julessouren/kicad-library/README.md

# kicad-library

Attempt at creating a better library system via GitHub
