julessouren/kicad-library/Libraries - Archive/Archive - Models/3dfiles-for-pedal-various/Neutrik_Jacks-master/Neutrik_STLs/Neutrik_NMJ4HCD2.stl.stl

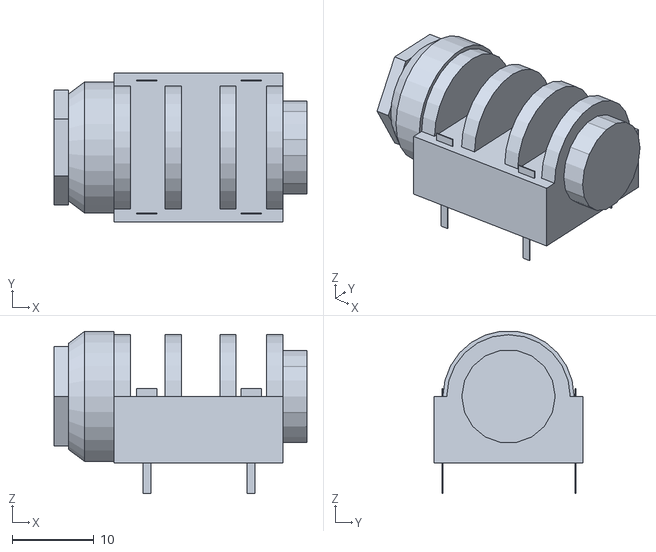
[picture p1: CAD file, 2019-09-03, an earlier design]
Libraries - Archive/Archive - Models/3dfiles-for-pedal-various/Neutrik_Jacks-master/Neutrik_STLs/Neutrik_NMJ4HCD2.stl.stl
30.9 x 18.2 x 19.8
