julessouren/kicad-library/Libraries - Archive/Archive - Models/Capacitors-THT-Film/User Library-Cap 10n - 630V Poly_2009.step

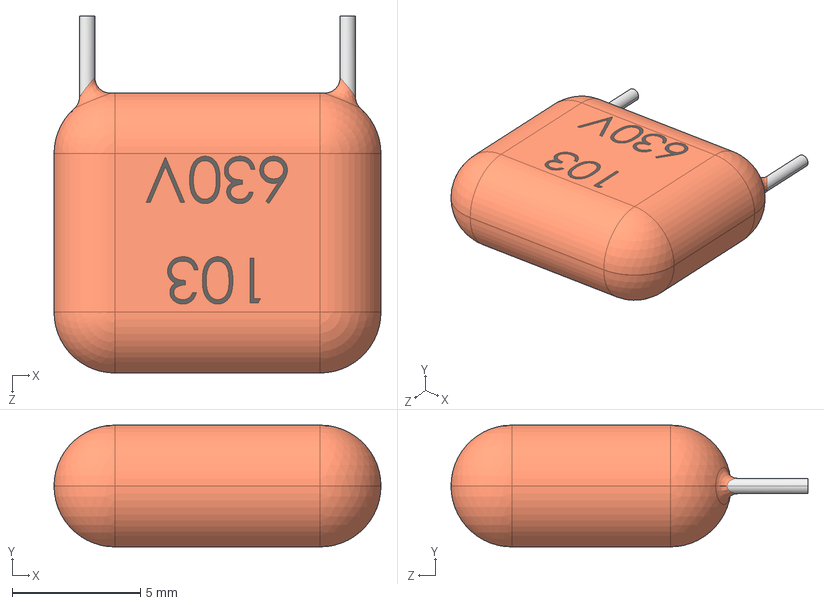
[picture p2: CAD file, 2019-09-03, an earlier design]
Libraries - Archive/Archive - Models/Capacitors-THT-Film/User Library-Cap 10n - 630V Poly_2009.step
12.8 x 4.75 x 13.9 mm
