julessouren/kicad-library/Libraries - Archive/Archive - Models/Capacitors-THT-Tantalum/User Library-CAP_TANT_0_1.step

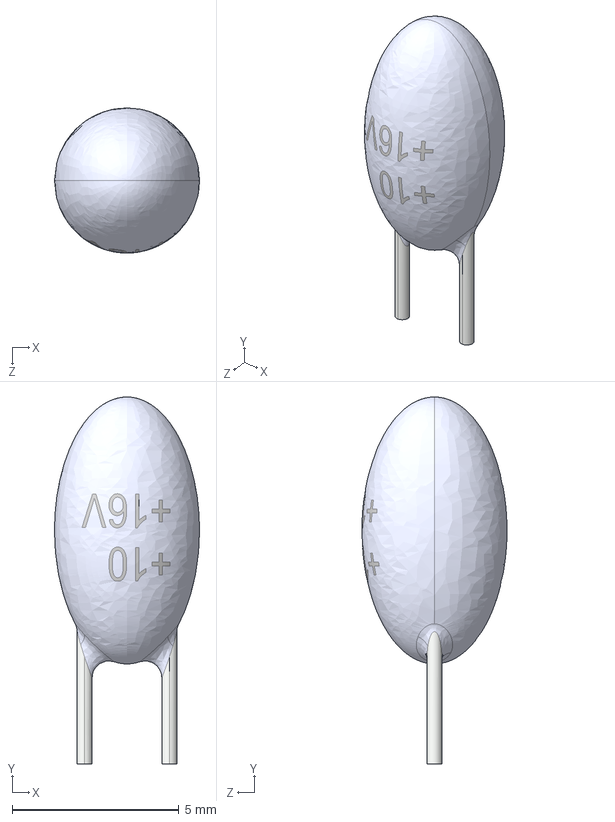
[picture p3: CAD file, 2019-09-03, an earlier design]
Libraries - Archive/Archive - Models/Capacitors-THT-Tantalum/User Library-CAP_TANT_0_1.step
4.35 x 11.0 x 4.35 mm
