julessouren/kicad-library/Libraries - Archive/Archive - Models/Enclosures/1590LB.stp

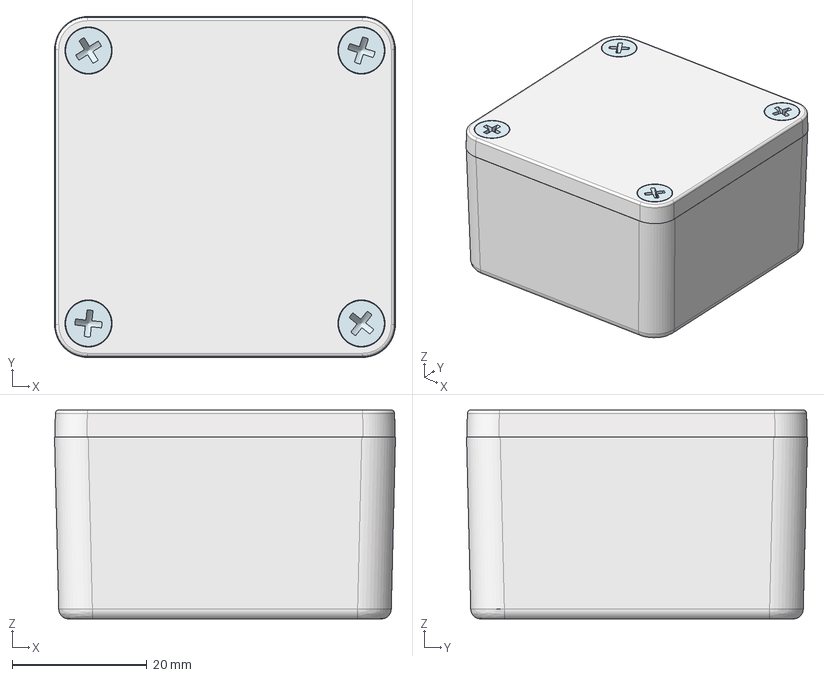
[picture p4: CAD file, 2019-09-03, an earlier design]
Libraries - Archive/Archive - Models/Enclosures/1590LB.stp
50.6 x 50.6 x 31.0 mm
1590LB Box
1590LB Lid
6-32 x 1/2" MACH. SCREW x 4
