julessouren/kicad-library/Libraries - Archive/Archive - Models/Jacks/Untitled Folder/Neutrik_Jacks-master/Neutrik_STLs/Neutrik_NRJ6HF.stl.stl

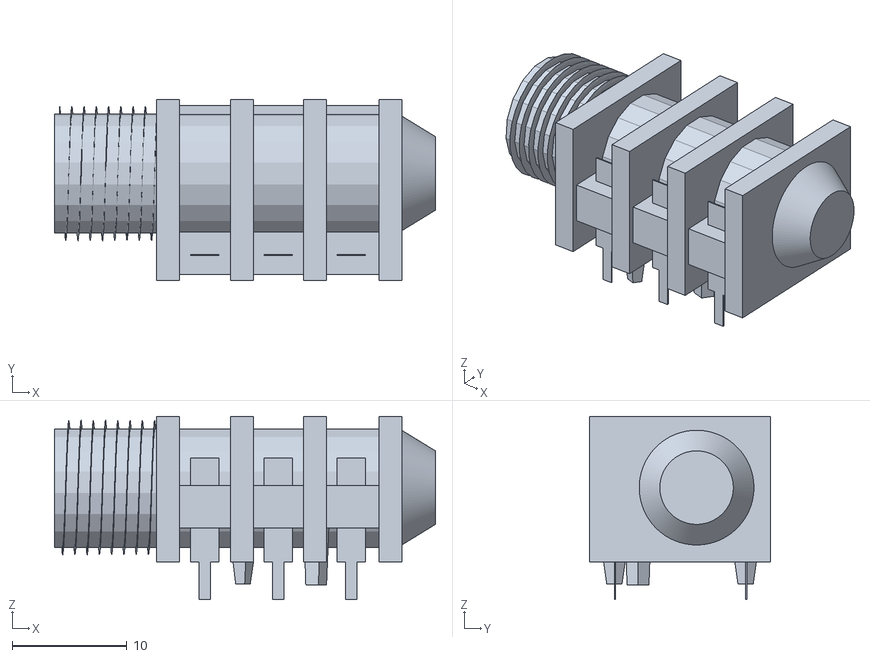
[picture p5: CAD file, 2019-09-03, an earlier design]
Libraries - Archive/Archive - Models/Jacks/Untitled Folder/Neutrik_Jacks-master/Neutrik_STLs/Neutrik_NRJ6HF.stl.stl
33.2 x 15.8 x 15.9
