julessouren/kicad-library/Libraries - Archive/Archive - Models/Potentiometers/Alpha9mm.step

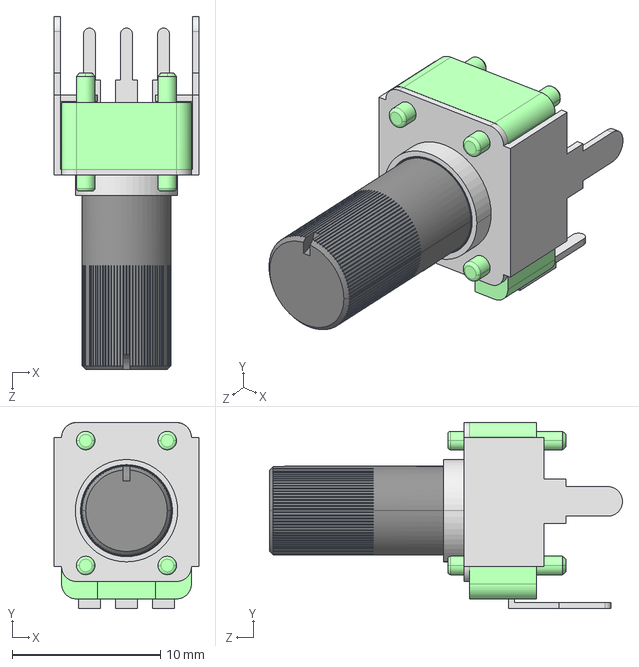
[picture p6: CAD file, 2019-09-03, an earlier design]
Libraries - Archive/Archive - Models/Potentiometers/Alpha9mm.step
9.75 x 12.6 x 23.8 mm
