julessouren/kicad-library/Libraries - Archive/Archive - Models/Trimpots/User Library-Bourns 3362P.step

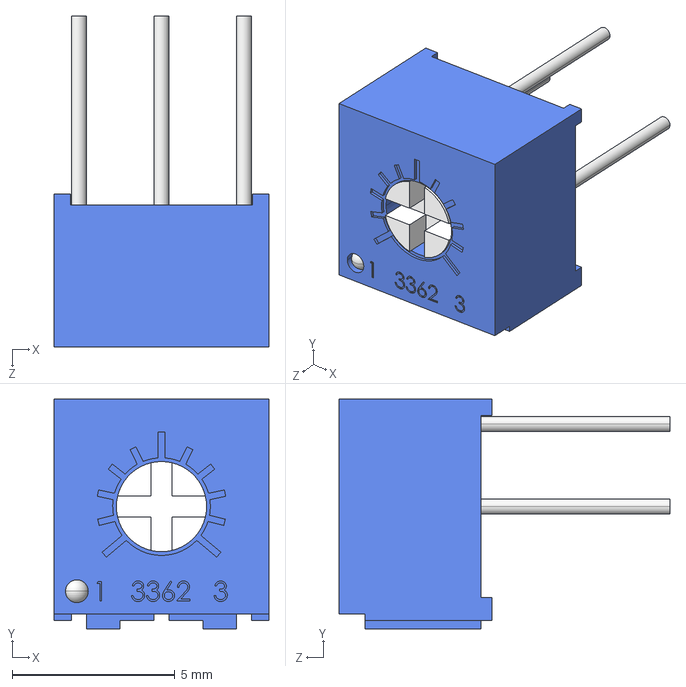
[picture p7: CAD file, 2019-09-03, an earlier design]
Libraries - Archive/Archive - Models/Trimpots/User Library-Bourns 3362P.step
6.60 x 7.05 x 10.2 mm
