julessouren/kicad-library/Libraries - Archive/Archive - Models/3dfiles-for-pedal-various/Neutrik_Jacks-master/Neutrik_STLs/Neutrik_NMJ4HFD2.stl.stl

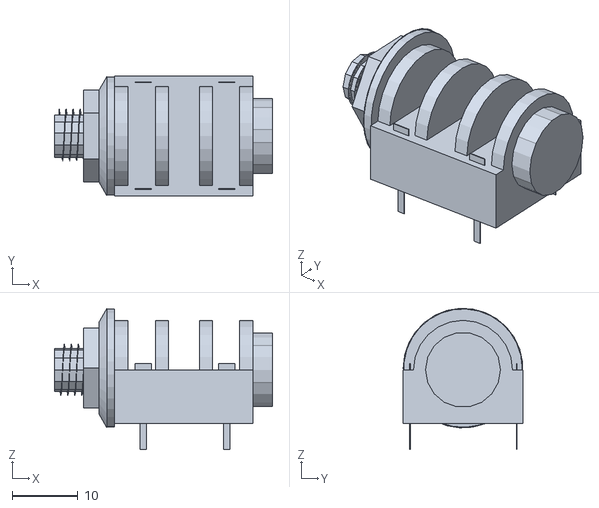
[picture p8: CAD file, 2019-09-03, an earlier design]
Libraries - Archive/Archive - Models/3dfiles-for-pedal-various/Neutrik_Jacks-master/Neutrik_STLs/Neutrik_NMJ4HFD2.stl.stl
33.1 x 18.2 x 21.5
