julessouren/kicad-library/Libraries - Archive/Archive - Models/Jacks/Untitled Folder/Neutrik_Jacks-master/Neutrik_STLs/Neutrik_NRJ4HF.stl.stl

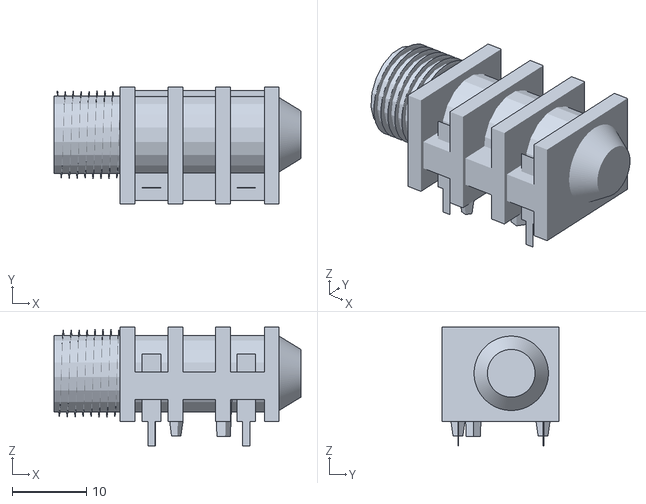
[picture p9: CAD file, 2019-09-03, an earlier design]
Libraries - Archive/Archive - Models/Jacks/Untitled Folder/Neutrik_Jacks-master/Neutrik_STLs/Neutrik_NRJ4HF.stl.stl
33.2 x 15.8 x 15.9
