julessouren/kicad-library/Libraries - Archive/Archive - Models/3dfiles-for-pedal-various/Neutrik_Jacks-master/Neutrik_STLs/Neutrik_NMJ6HCD3.stl.stl

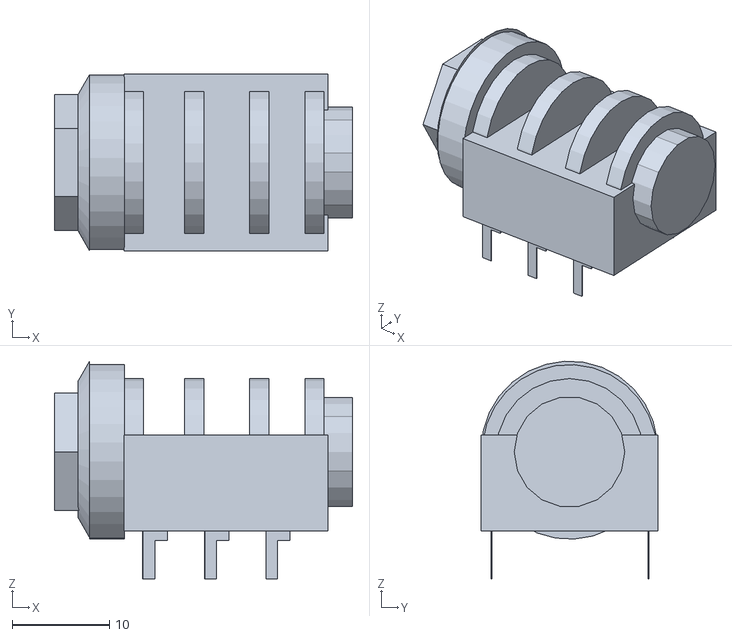
[picture p10: CAD file, 2019-09-03, an earlier design]
Libraries - Archive/Archive - Models/3dfiles-for-pedal-various/Neutrik_Jacks-master/Neutrik_STLs/Neutrik_NMJ6HCD3.stl.stl
30.7 x 18.2 x 22.4
