julessouren/kicad-library/(list of files, cad)

Other CAD files:
Libraries - Archive/Archive - Models/Potentiometers/Alpha9mmstepold.step
Libraries - Archive/Archive - Models/Jacks/Untitled Folder/Neutrik_Jacks-master/Neutrik_STLs/Neutrik_NMJ6HCD2.stl.stl
Libraries - Archive/Archive - Models/3dfiles-for-pedal-various/Neutrik_Jacks-master/Neutrik_STLs/Neutrik_NMJ6HCD2.stl.stl
Libraries - Archive/Archive - Models/3dfiles-for-pedal-various/Neutrik_Jacks-master/Neutrik_STLs/Neutrik_NMJ6HHD2.stl.stl
Libraries - Archive/Archive - Models/Jacks/Untitled Folder/Neutrik_Jacks-master/Neutrik_STLs/Neutrik_NRJ6HH.stl.stl
Libraries - Archive/Archive - Models/3dfiles-for-pedal-various/Neutrik_Jacks-master/Neutrik_openScad/Neutrik_NMJ4HCD2.scad
Libraries - Archive/Archive - Models/3dfiles-for-pedal-various/Neutrik_Jacks-master/Neutrik_openScad/Neutrik_NMJ4HFD2.scad
Libraries - Archive/Archive - Models/3dfiles-for-pedal-various/Neutrik_Jacks-master/Neutrik_openScad/Neutrik_NMJ4HFD3.scad
Libraries - Archive/Archive - Models/3dfiles-for-pedal-various/Neutrik_Jacks-master/Neutrik_openScad/Neutrik_NMJ4HHD2.scad
Libraries - Archive/Archive - Models/3dfiles-for-pedal-various/Neutrik_Jacks-master/Neutrik_STLs/Neutrik_NMJ4HFD3.stl.stl
Libraries - Archive/Archive - Models/3dfiles-for-pedal-various/Neutrik_Jacks-master/Neutrik_STLs/Neutrik_NMJ4HHD2.stl.stl
Libraries - Archive/Archive - Models/3dfiles-for-pedal-various/Neutrik_Jacks-master/Neutrik_STLs/Neutrik_NMJ6HFD2.stl.stl
Libraries - Archive/Archive - Models/3dfiles-for-pedal-various/Neutrik_Jacks-master/Neutrik_STLs/Neutrik_NMJ6HFD3.stl.stl
Libraries - Archive/Archive - Models/3dfiles-for-pedal-various/Neutrik_Jacks-master/Neutrik_STLs/Neutrik_NRJ3HF.stl.stl
Libraries - Archive/Archive - Models/3dfiles-for-pedal-various/Neutrik_Jacks-master/Neutrik_STLs/Neutrik_NRJ4HH.stl.stl
Libraries - Archive/Archive - Models/3dfiles-for-pedal-various/Neutrik_Jacks-master/Neutrik_STLs/Neutrik_NRJ6HH.stl.stl
Libraries - Archive/Archive - Models/3dfiles-for-pedal-various/Neutrik_Jacks-master/Neutrik_STLs/Neutrik_NRJ6HM-1.stl.stl
Libraries - Archive/Archive - Models/3dfiles-for-pedal-various/Neutrik_Jacks-master/Neutrik_openScad/Neutrik_NMJ6HCD2.scad
Libraries - Archive/Archive - Models/3dfiles-for-pedal-various/Neutrik_Jacks-master/Neutrik_openScad/Neutrik_NMJ6HCD3.scad
Libraries - Archive/Archive - Models/3dfiles-for-pedal-various/Neutrik_Jacks-master/Neutrik_openScad/Neutrik_NMJ6HFD2.scad
Libraries - Archive/Archive - Models/3dfiles-for-pedal-various/Neutrik_Jacks-master/Neutrik_openScad/Neutrik_NMJ6HFD3.scad
Libraries - Archive/Archive - Models/3dfiles-for-pedal-various/Neutrik_Jacks-master/Neutrik_openScad/Neutrik_NMJ6HHD2.scad
Libraries - Archive/Archive - Models/3dfiles-for-pedal-various/Neutrik_Jacks-master/Neutrik_openScad/Neutrik_NRJ3HF.scad
Libraries - Archive/Archive - Models/3dfiles-for-pedal-various/Neutrik_Jacks-master/Neutrik_openScad/Neutrik_NRJ4HF.scad
Libraries - Archive/Archive - Models/3dfiles-for-pedal-various/Neutrik_Jacks-master/Neutrik_openScad/Neutrik_NRJ4HH.scad
Libraries - Archive/Archive - Models/3dfiles-for-pedal-various/Neutrik_Jacks-master/Neutrik_openScad/Neutrik_NRJ6HF.scad
Libraries - Archive/Archive - Models/3dfiles-for-pedal-various/Neutrik_Jacks-master/Neutrik_openScad/Neutrik_NRJ6HH.scad
Libraries - Archive/Archive - Models/3dfiles-for-pedal-various/Neutrik_Jacks-master/Neutrik_openScad/Neutrik_NRJ6HM-1.scad
Libraries - Archive/Archive - Models/3dfiles-for-pedal-various/Neutrik_Jacks-master/Neutrik_openScad/Neutrik_NRJ6HM-1_PRE.scad
Libraries - Archive/Archive - Models/Capacitors-THT-Film/User Library-Cap 10n - 630V Poly_2009.igs
Libraries - Archive/Archive - Models/Enclosures/1590LB.igs
Libraries - Archive/Archive - Models/Jacks/Untitled Folder/Neutrik_Jacks-master/Neutrik_STLs/Neutrik_NMJ4HFD3.stl.stl
Libraries - Archive/Archive - Models/Jacks/Untitled Folder/Neutrik_Jacks-master/Neutrik_STLs/Neutrik_NMJ4HHD2.stl.stl
Libraries - Archive/Archive - Models/Jacks/Untitled Folder/Neutrik_Jacks-master/Neutrik_STLs/Neutrik_NMJ6HFD2.stl.stl
Libraries - Archive/Archive - Models/Jacks/Untitled Folder/Neutrik_Jacks-master/Neutrik_STLs/Neutrik_NMJ6HFD3.stl.stl
Libraries - Archive/Archive - Models/Jacks/Untitled Folder/Neutrik_Jacks-master/Neutrik_STLs/Neutrik_NMJ6HHD2.stl.stl
Libraries - Archive/Archive - Models/Jacks/Untitled Folder/Neutrik_Jacks-master/Neutrik_STLs/Neutrik_NRJ3HF.stl.stl
Libraries - Archive/Archive - Models/Jacks/Untitled Folder/Neutrik_Jacks-master/Neutrik_STLs/Neutrik_NRJ4HH.stl.stl
Libraries - Archive/Archive - Models/Jacks/Untitled Folder/Neutrik_Jacks-master/Neutrik_STLs/Neutrik_NRJ6HM-1.stl.stl
Libraries - Archive/Archive - Models/Jacks/Untitled Folder/Neutrik_Jacks-master/Neutrik_openScad/Neutrik_NMJ4HCD2.scad
Libraries - Archive/Archive - Models/Jacks/Untitled Folder/Neutrik_Jacks-master/Neutrik_openScad/Neutrik_NMJ4HFD2.scad
Libraries - Archive/Archive - Models/Jacks/Untitled Folder/Neutrik_Jacks-master/Neutrik_openScad/Neutrik_NMJ4HFD3.scad
Libraries - Archive/Archive - Models/Jacks/Untitled Folder/Neutrik_Jacks-master/Neutrik_openScad/Neutrik_NMJ4HHD2.scad
Libraries - Archive/Archive - Models/Jacks/Untitled Folder/Neutrik_Jacks-master/Neutrik_openScad/Neutrik_NMJ6HCD2.scad
Libraries - Archive/Archive - Models/Jacks/Untitled Folder/Neutrik_Jacks-master/Neutrik_openScad/Neutrik_NMJ6HCD3.scad
Libraries - Archive/Archive - Models/Jacks/Untitled Folder/Neutrik_Jacks-master/Neutrik_openScad/Neutrik_NMJ6HFD2.scad
Libraries - Archive/Archive - Models/Jacks/Untitled Folder/Neutrik_Jacks-master/Neutrik_openScad/Neutrik_NMJ6HFD3.scad
Libraries - Archive/Archive - Models/Jacks/Untitled Folder/Neutrik_Jacks-master/Neutrik_openScad/Neutrik_NMJ6HHD2.scad
Libraries - Archive/Archive - Models/Jacks/Untitled Folder/Neutrik_Jacks-master/Neutrik_openScad/Neutrik_NRJ3HF.scad
Libraries - Archive/Archive - Models/Jacks/Untitled Folder/Neutrik_Jacks-master/Neutrik_openScad/Neutrik_NRJ4HF.scad
Libraries - Archive/Archive - Models/Jacks/Untitled Folder/Neutrik_Jacks-master/Neutrik_openScad/Neutrik_NRJ4HH.scad
Libraries - Archive/Archive - Models/Jacks/Untitled Folder/Neutrik_Jacks-master/Neutrik_openScad/Neutrik_NRJ6HF.scad
Libraries - Archive/Archive - Models/Jacks/Untitled Folder/Neutrik_Jacks-master/Neutrik_openScad/Neutrik_NRJ6HH.scad
Libraries - Archive/Archive - Models/Jacks/Untitled Folder/Neutrik_Jacks-master/Neutrik_openScad/Neutrik_NRJ6HM-1.scad
Libraries - Archive/Archive - Models/Jacks/Untitled Folder/Neutrik_Jacks-master/Neutrik_openScad/Neutrik_NRJ6HM-1_PRE.scad
