julessouren/kicad-library/(commit log)

2019-08-02 Kicad Library update
2019-09-03 rename and added archive
    [1590LB.igs, 1590LB.stp, Alpha9mm.step, Alpha9mmstepold.step, Neutrik_NMJ4HCD2.scad, Neutrik_NMJ4HCD2.stl.stl, Neutrik_NMJ4HFD2.scad, Neutrik_NMJ4HFD2.stl.stl]
